rimutaka/folding-furniture/(list of files, cad)

Other CAD files:
ordering/feet-cutout.dxf
ordering/coupler-housing-cutout.dxf
ordering/top-cutout.dxf
ordering/all-parts-x3.dxf
ordering/coupler-interface-cutout.dxf
ordering/all-parts-cutout.dxf
