rimutaka/folding-furniture/(commit log)

2020-03-25 1st prototype with dowels.
    [all-parts-cutout.dxf, all-parts-x3.dxf, coupler-housing-cutout.dxf, coupler-interface-cutout.dxf, feet-cutout.dxf, top-cutout.dxf]
2020-03-25 Added GIT LFS support.
    [all-parts-cutout.dxf, all-parts-x3.dxf, coupler-housing-cutout.dxf, coupler-interface-cutout.dxf, feet-cutout.dxf, top-cutout.dxf]
